mcupka/F0DisplayBoard/Components/Sophie/122861954_10218880609430510_2509081927859119019_n.jpg

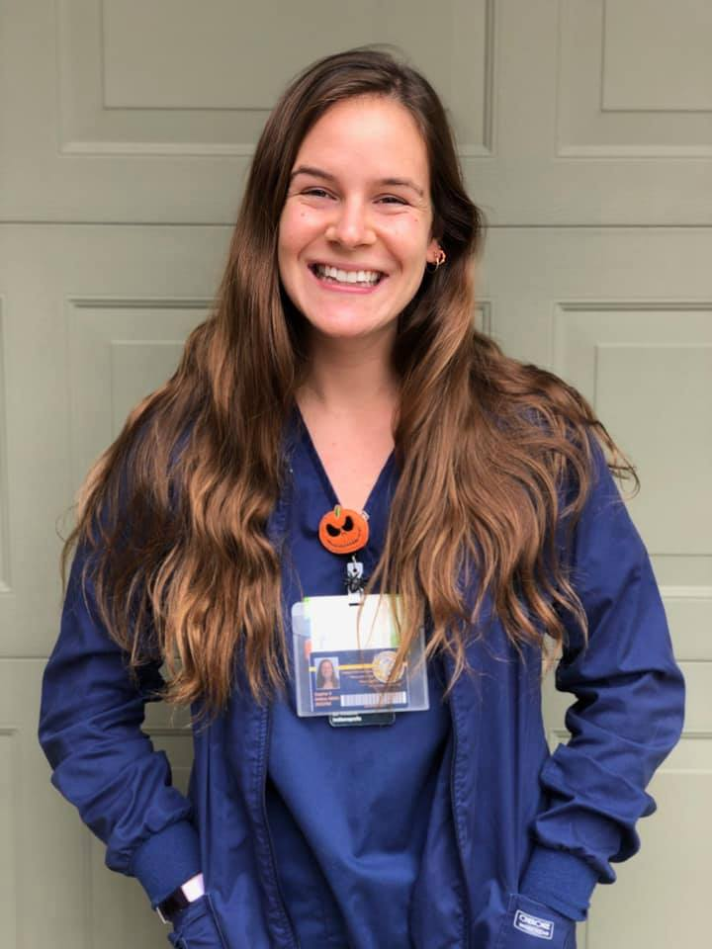
Components/Sophie/122861954_10218880609430510_2509081927859119019_n.jpg
