mcupka/F0DisplayBoard/3D_Models/pcb_casetop.stl

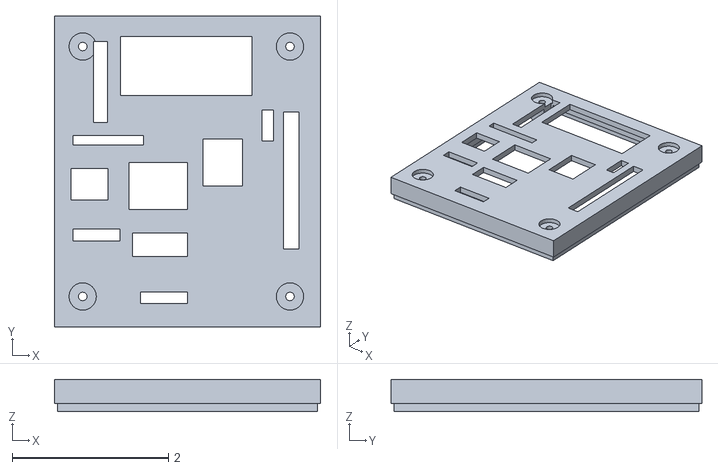
[picture p2: CAD file, 2020-12-15]
3D_Models/pcb_casetop.stl
3.40 x 3.98 x 0.41
