mcupka/F0DisplayBoard/3D_Models/pcb_casebottom_r2.stl

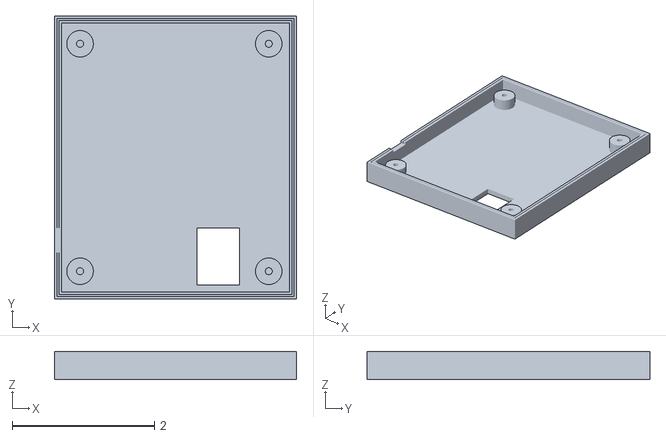
[picture p3: CAD file, 2020-12-15]
3D_Models/pcb_casebottom_r2.stl
3.40 x 3.98 x 0.4
