mcupka/F0DisplayBoard/3D_Models/pcb_stand.stl

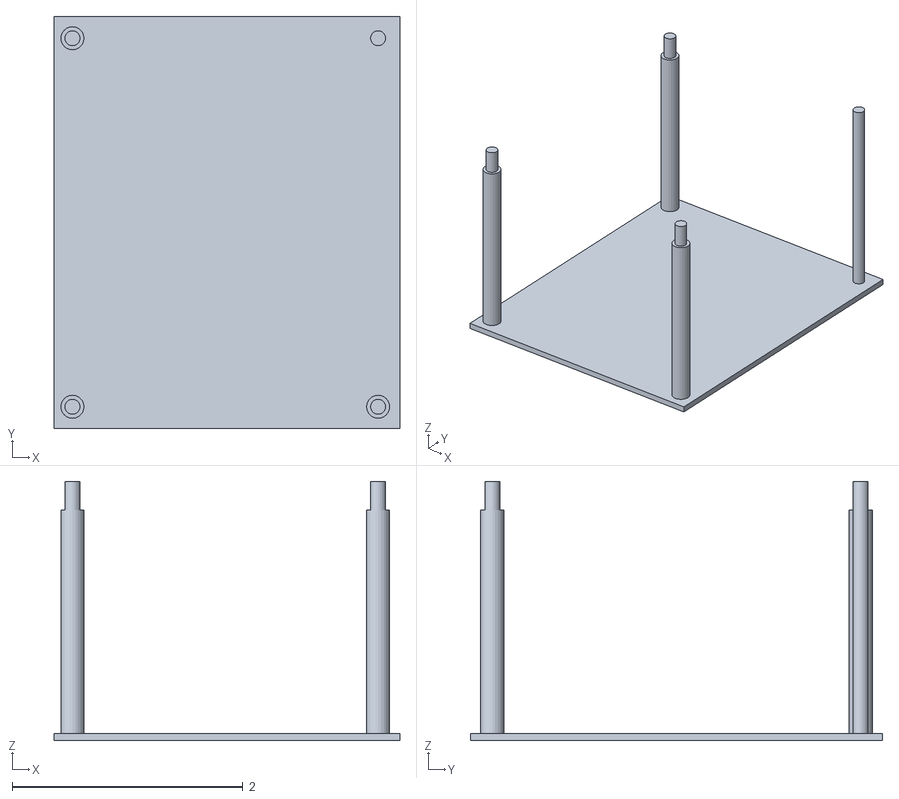
[picture p4: CAD file, 2020-12-15]
3D_Models/pcb_stand.stl
3.00 x 3.58 x 2.25
