mcupka/F0DisplayBoard/(list of files, cad)

Other CAD files:
3D_Models/pcb_casebottom_r2.dwg
3D_Models/pcb_casetop.dwg
