mcupka/F0DisplayBoard/F0DisplayBoard/F0DisplayBoard.kicad_pcb

## KiCad design F0DisplayBoard/F0DisplayBoard.kicad_pcb (2020-12-15)

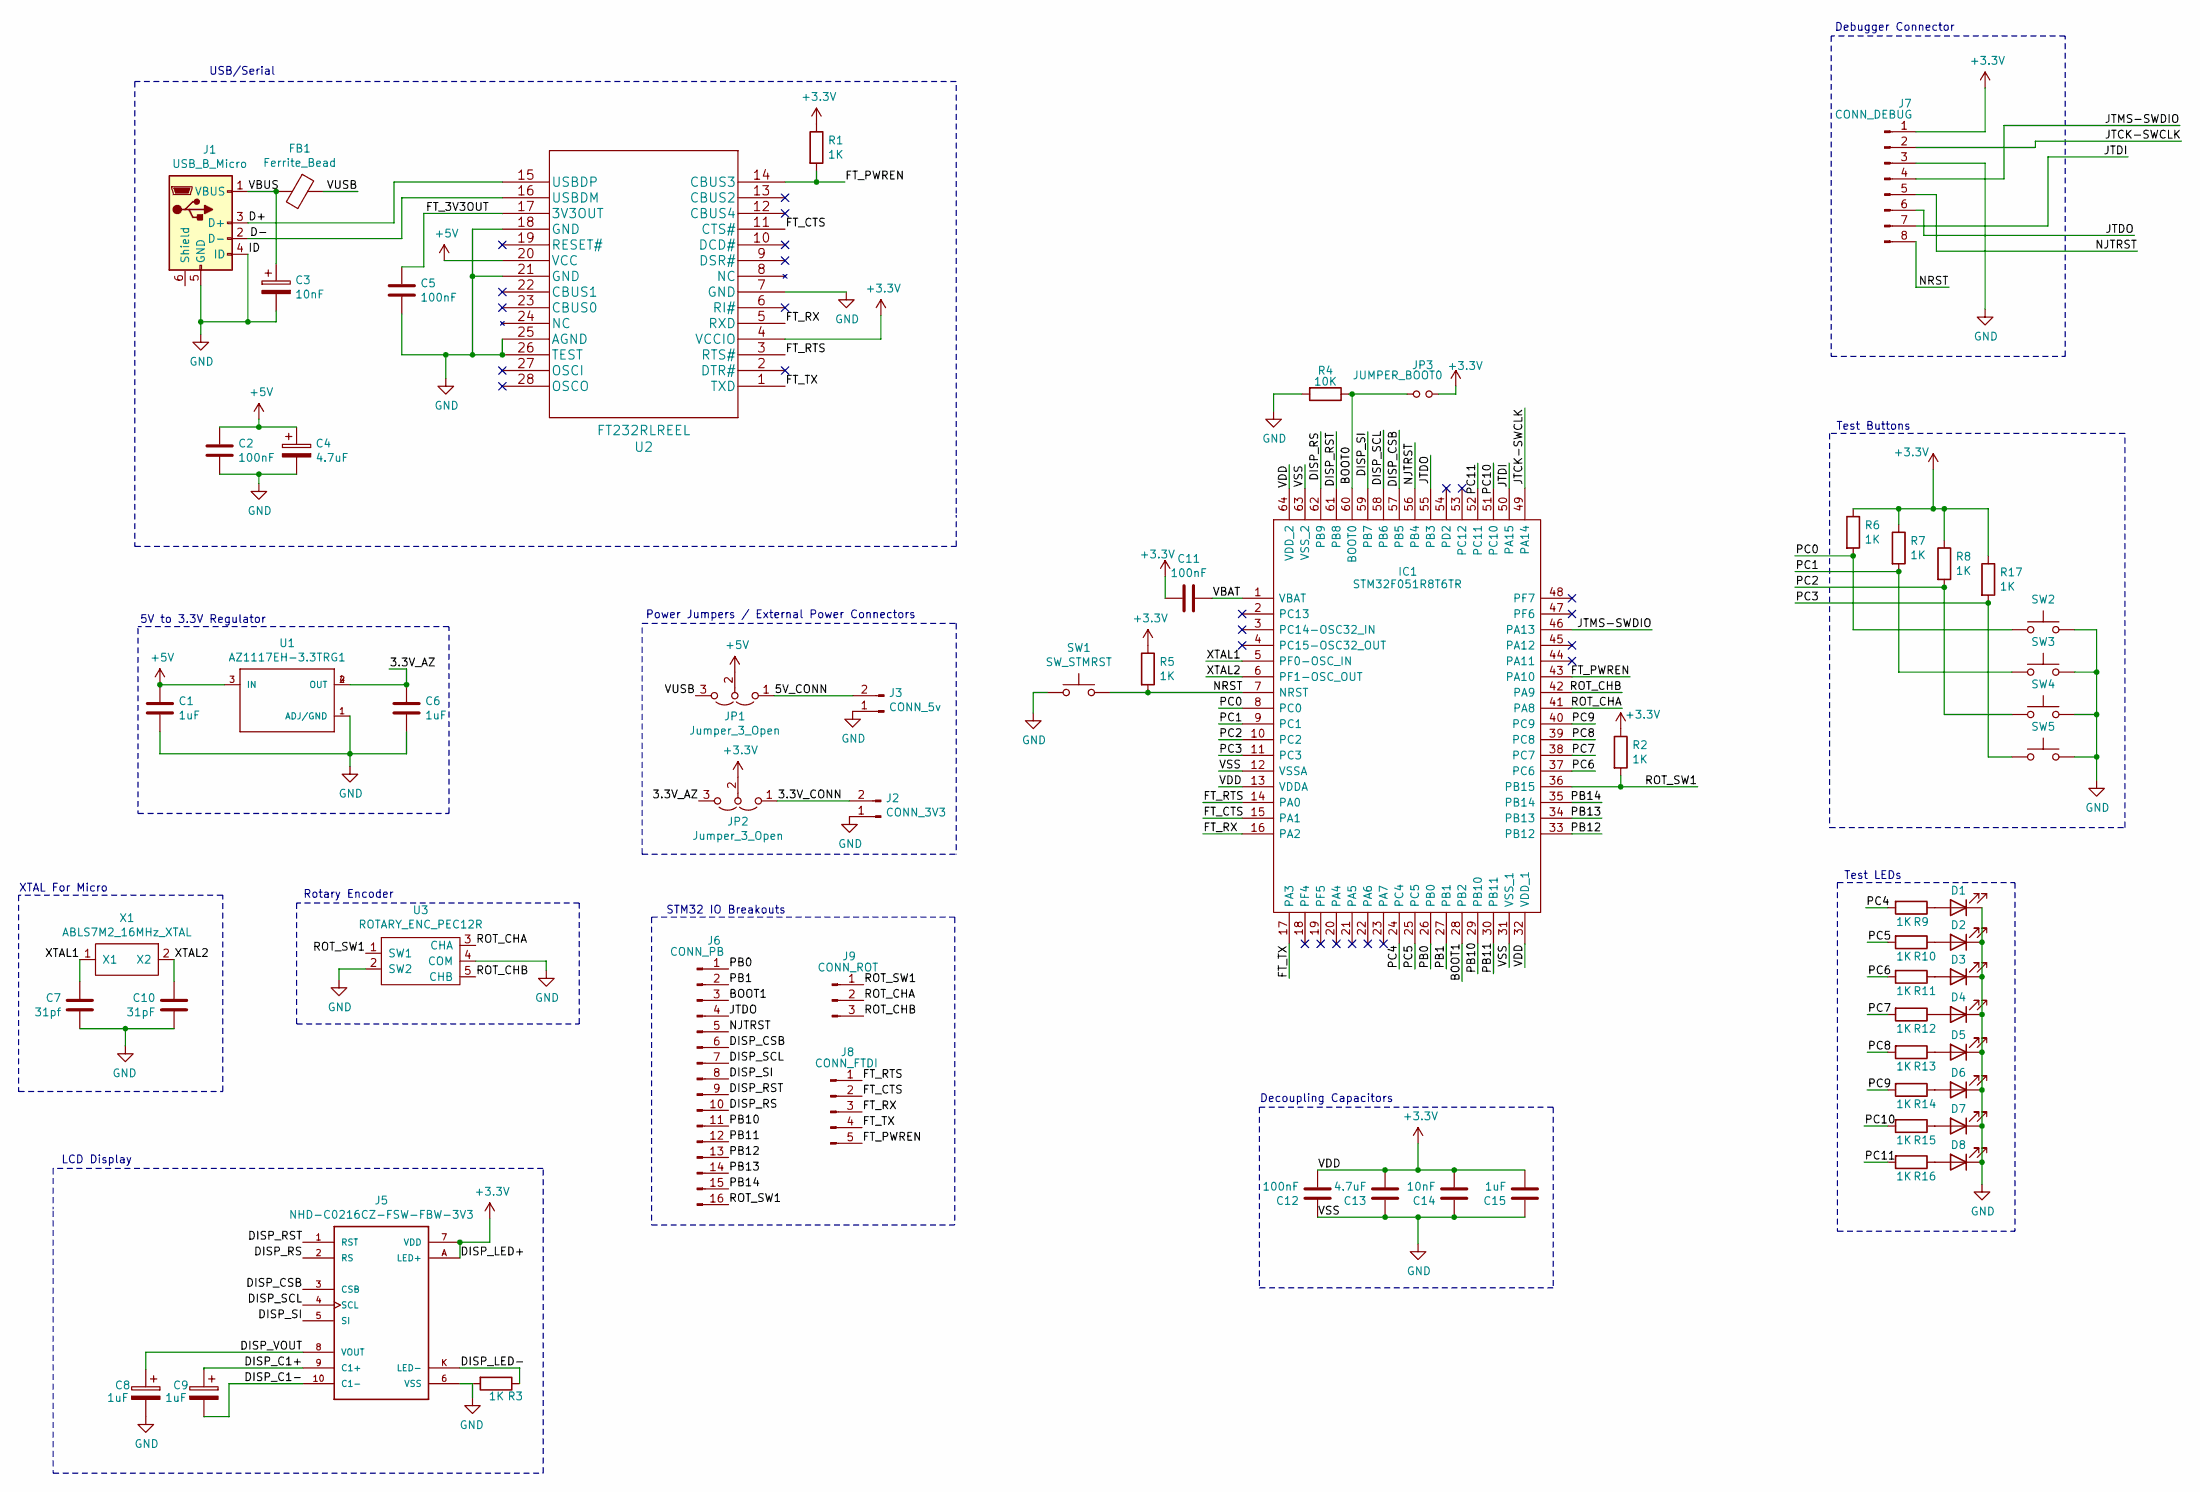
[picture p5: schematic F0DisplayBoard.sch]

Parts:
C1, C6, C8, C9, C15: 1uF; C_0805_2012Metric_Pad1.15x1.40mm_HandSolder
C2, C5, C11, C12: 100nF; C_0805_2012Metric_Pad1.15x1.40mm_HandSolder
C3, C14: 10nF; C_0805_2012Metric_Pad1.15x1.40mm_HandSolder
C4, C13: 4.7uF; C_0805_2012Metric_Pad1.15x1.40mm_HandSolder
C7: 31pf; C_0805_2012Metric_Pad1.15x1.40mm_HandSolder
C10: 31pF; C_0805_2012Metric_Pad1.15x1.40mm_HandSolder
D1, D2, D3, D4, D5, D6, D7, D8: LED; LED_0805_2012Metric_Pad1.15x1.40mm_HandSolder
FB1: Ferrite_Bead; R_0805_2012Metric_Pad1.15x1.40mm_HandSolder
IC1: STM32F051R8T6TR; QFP50P1200X1200X160-64N; Manufacturer_Part_Number STM32F051R8T6TR; Mouser Part Number 511-STM32F051R8T6TR
J1: USB_B_Micro; CUIDEVICES_UJ2-MIBH-4-SMT-TR
J2: CONN_3V3; PinHeader_1x02_P2.54mm_Vertical
J3: CONN_5v; PinHeader_1x02_P2.54mm_Vertical
J5: NHD-C0216CZ-FSW-FBW-3V3; LCD_NHD-C0216CZ-FSW-FBW-3V3
J6: CONN_PB; PinHeader_1x16_P2.54mm_Vertical
J7: CONN_DEBUG; PinHeader_1x08_P2.54mm_Vertical
J8: CONN_FTDI; PinHeader_1x05_P2.54mm_Vertical
J9: CONN_ROT; PinHeader_1x03_P2.54mm_Vertical
JP1, JP2: Jumper_3_Open; PinHeader_1x03_P2.54mm_Vertical
JP3: JUMPER_BOOT0; PinHeader_1x02_P2.54mm_Vertical
R1, R2, R3, R5, R6, R7, R8, R9, R10, R11, R12, R13, R14, R15, R16, R17: 1K; R_0805_2012Metric_Pad1.15x1.40mm_HandSolder
R4: 10K; R_0805_2012Metric_Pad1.15x1.40mm_HandSolder
SW1: SW_STMRST; PTS645SK43SMTR92LFS
SW2, SW3, SW4, SW5: SW_Push; PTS645SK43SMTR92LFS
U1: AZ1117EH-3.3TRG1; SOT230P700X180-4N
U2: FT232RLREEL
U3: ROTARY_ENC_PEC12R
X1: ABLS7M2_16MHz_XTAL; ABLS7M2

Connections:
+3V3: C11.2, C12.1, C13.1, C14.1, C15.1, IC1.13 (VDDA), IC1.32 (VDD_1), IC1.64 (VDD_2), J5.7 (VDD), J5.A (LED+), J7.1, JP2.2 (C), JP3.2, R1.1, R2.1, R5.1, R6.1, R7.1, R8.1, R17.1, U2.4 (VCCIO)
+5V: C1.1, C2.1, C4.1, JP1.2 (C), U1.3 (IN), U2.20 (VCC)
/3.3V_AZ: C6.1, JP2.3 (B), U1.2 (OUT), U1.4 (OUT)
/3.3V_CONN: J2.2, JP2.1 (A)
/5V_CONN: J3.2, JP1.1 (A)
/BOOT0: IC1.60 (BOOT0), JP3.1, R4.1
/BOOT1: IC1.28 (PB2), J6.3
/D+: J1.3 (D+), U2.15 (USBDP)
/D-: J1.2 (D-), U2.16 (USBDM)
/DISP_C1+: C9.1, J5.9 (C1+)
/DISP_C1-: C9.2, J5.10 (C1-)
/DISP_CSB: IC1.57 (PB5), J5.3 (CSB), J6.6
/DISP_LED-: J5.K (LED-), R3.1
/DISP_RS: IC1.62 (PB9), J5.2 (RS), J6.10
/DISP_RST: IC1.61 (PB8), J5.1 (RST), J6.9
/DISP_SCL: IC1.58 (PB6), J5.4 (SCL), J6.7
/DISP_SI: IC1.59 (PB7), J5.5 (SI), J6.8
/DISP_VOUT: C8.1, J5.8 (VOUT)
/FT_3V3OUT: C5.1, U2.17 (3V3OUT)
/FT_CTS: IC1.15 (PA1), J8.2, U2.11 (CTS#)
/FT_PWREN: IC1.43 (PA10), J8.5, R1.2, U2.14 (CBUS3)
/FT_RTS: IC1.14 (PA0), J8.1, U2.3 (RTS#)
/FT_RX: IC1.16 (PA2), J8.3, U2.5 (RXD)
/FT_TX: IC1.17 (PA3), J8.4, U2.1 (TXD)
/JTCK-SWCLK: IC1.49 (PA14), J7.2
/JTDI: IC1.50 (PA15), J7.7
/JTDO: IC1.55 (PB3), J6.4, J7.6
/JTMS-SWDIO: IC1.46 (PA13), J7.4
/NJTRST: IC1.56 (PB4), J6.5, J7.5
/NRST: IC1.7 (NRST), J7.8, R5.2, SW1.3, SW1.4
/PB0: IC1.26 (PB0), J6.1
/PB1: IC1.27 (PB1), J6.2
/PB10: IC1.29 (PB10), J6.11
/PB11: IC1.30 (PB11), J6.12
/PB12: IC1.33 (PB12), J6.13
/PB13: IC1.34 (PB13), J6.14
/PB14: IC1.35 (PB14), J6.15
/PC0: IC1.8 (PC0), R6.2, SW2.1, SW2.2
/PC1: IC1.9 (PC1), R7.2, SW3.1, SW3.2
/PC2: IC1.10 (PC2), R8.2, SW4.1, SW4.2
/PC3: IC1.11 (PC3), R17.2, SW5.1, SW5.2
/PC4: IC1.24 (PC4), R9.2
/PC5: IC1.25 (PC5), R10.2
/PC6: IC1.37 (PC6), R11.2
/PC7: IC1.38 (PC7), R12.2
/PC8: IC1.39 (PC8), R13.2
/PC9: IC1.40 (PC9), R14.2
/PC10: IC1.51 (PC10), R15.2
/PC11: IC1.52 (PC11), R16.2
/ROT_CHA: IC1.41 (PA8), J9.2, U3.3 (CHA)
/ROT_CHB: IC1.42 (PA9), J9.3, U3.5 (CHB)
/ROT_SW1: IC1.36 (PB15), J6.16, J9.1, R2.2, U3.1 (SW1)
/VBAT: C11.1, IC1.1 (VBAT)
/VBUS: C3.1, FB1.2, J1.1 (VBUS)
/VUSB: FB1.1, JP1.3 (B)
/XTAL1: C7.1, IC1.5 (PF0-OSC_IN), X1.1 (X1)
/XTAL2: C10.1, IC1.6 (PF1-OSC_OUT), X1.2 (X2)
GND: C1.2, C2.2, C3.2, C4.2, C5.2, C6.2, C7.2, C8.2, C10.2, C12.2, C13.2, C14.2, C15.2, D1.1 (K), D2.1 (K), D3.1 (K), D4.1 (K), D5.1 (K), D6.1 (K), D7.1 (K), D8.1 (K), IC1.12 (VSSA), IC1.31 (VSS_1), IC1.63 (VSS_2), J1.4 (ID), J1.5 (GND), J2.1, J3.1, J5.6 (VSS), J7.3, R3.2, R4.2, SW1.1, SW1.2, SW2.3, SW2.4, SW3.3, SW3.4, SW4.3, SW4.4, SW5.3, SW5.4, U1.1 (ADJ/GND), U2.7 (GND), U2.18 (GND), U2.21 (GND), U2.25 (AGND), U2.26 (TEST), U3.2 (SW2), U3.4 (COM)
unnamed: D1.2 (A), R9.1
unnamed: D2.2 (A), R10.1
unnamed: D3.2 (A), R11.1
unnamed: D4.2 (A), R12.1
unnamed: D5.2 (A), R13.1
unnamed: D6.2 (A), R14.1
unnamed: D7.2 (A), R15.1
unnamed: D8.2 (A), R16.1

Notes on the sheet:
5V to 3.3V Regulator
Rotary Encoder
XTAL For Micro
LCD Display
Power Jumpers / External Power Connectors
Debugger Connector
STM32 IO Breakouts
Test LEDs
Test Buttons
USB/Serial
Decoupling Capacitors

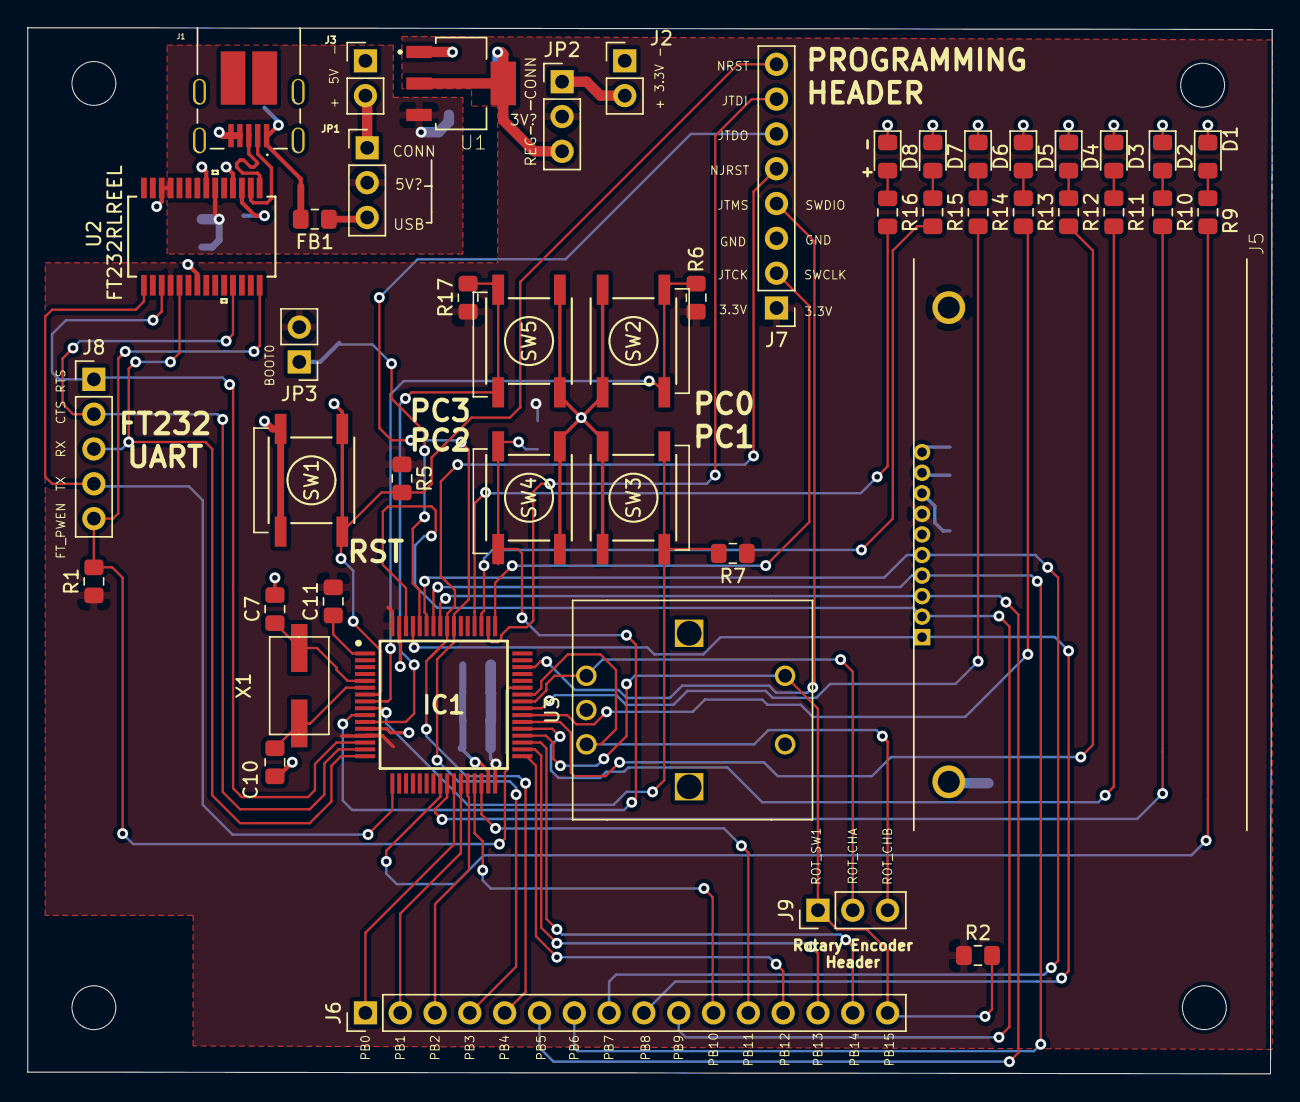
[picture p6: board F0DisplayBoard.kicad_pcb from above]

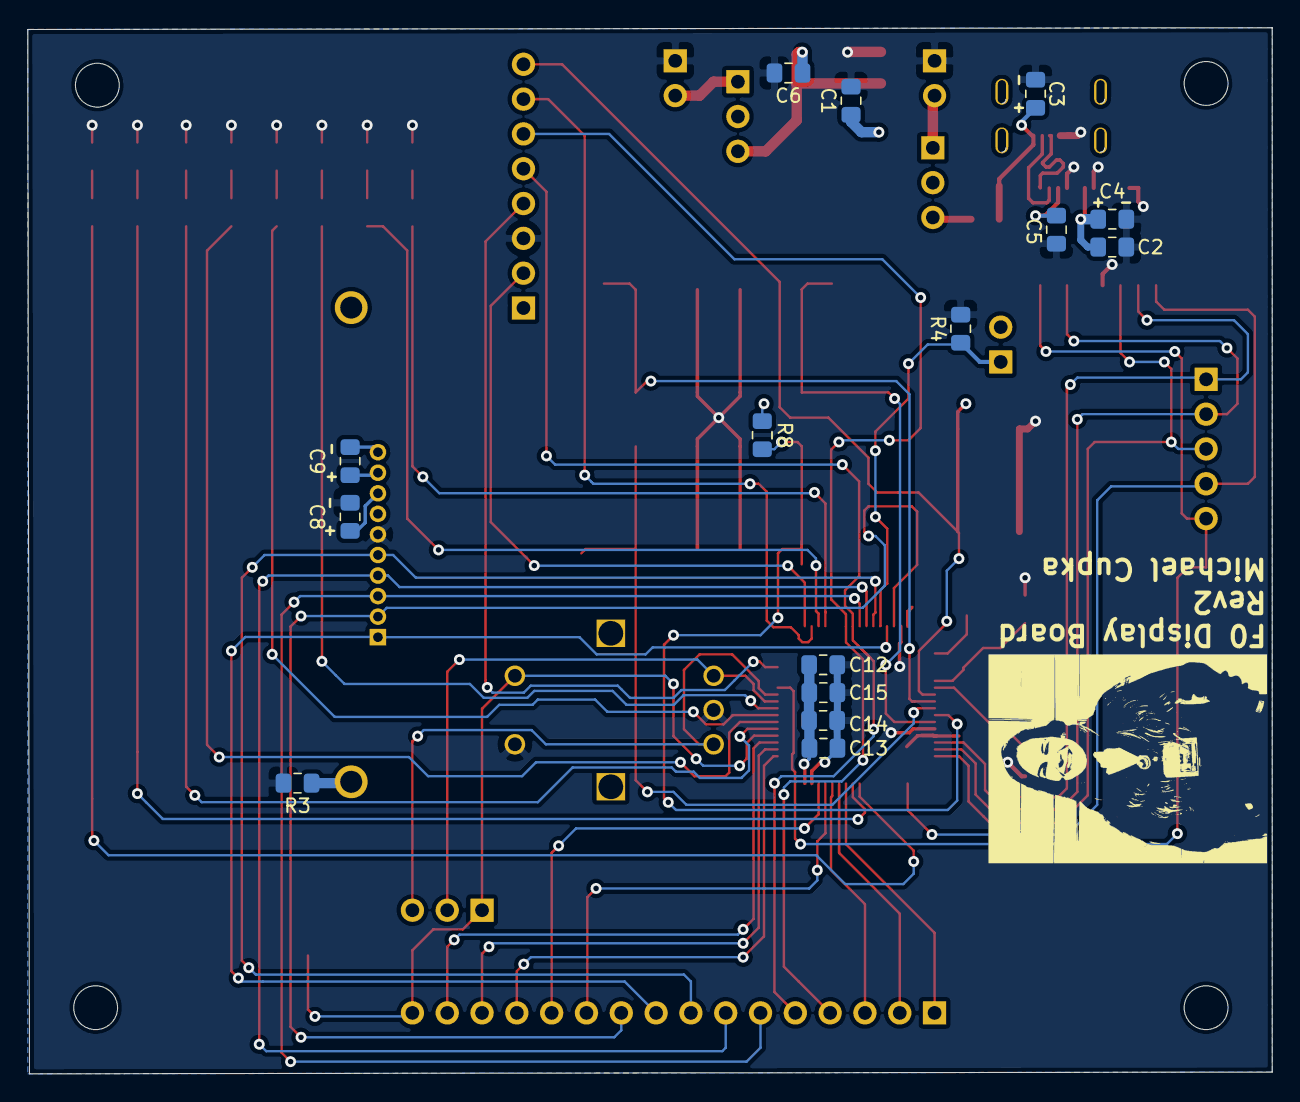
[picture p7: board F0DisplayBoard.kicad_pcb from below]

Board: 2 copper layers, 90.8 x 76.3 mm, 62 parts (15 on the bottom side), 66 nets.
