mcupka/F0DisplayBoard/sw/stmcube_uart_test/stmcube_uart_test/stmcube_uart_test.ioc

Mcu.UserName=STM32F051R8Tx
PA2.Signal=USART2_TX
PA3.Signal=USART2_RX
