mcupka/F0DisplayBoard/(commit log)

2020-10-18 Initial Commit: -Basically done with the main schematic -Need to add test points/connectors/LEDs -Need to begin layout
    [F0DisplayBoard.kicad_pcb, F0DisplayBoard.sch]
2020-10-30 sch: Removed some connectors to make room on board. pcb: rough routing, difficulty with traces cutting into planes. May restart routing of most signals
    [F0DisplayBoard.kicad_pcb, F0DisplayBoard.sch]
2020-11-01 pcb: re-routed mostlyl orthogonally. Still need to get 3.3V plane to reach some pins and check other "unrouted" signals
    [F0DisplayBoard.kicad_pcb]
2020-11-21 Rev2 completed -Added current-limiting resitstor for LCD backlight -Fixed microcontroller footprint -Board size reduced
    [F0DisplayBoard-B_Cu.gbr, F0DisplayBoard-B_Mask.gbr, F0DisplayBoard-B_Paste.gbr, F0DisplayBoard-B_SilkS.gbr, F0DisplayBoard-Edge_Cuts.gbr, F0DisplayBoard-F_Cu.gbr, F0DisplayBoard-F_Mask.gbr, F0DisplayBoard-F_Paste.gbr]
2020-11-21 sw: started sw -simple uart print test completed using STMCubeMX, HAL, and SW4STM32
    [lab6 Run.cfg]
2020-12-04 sw: modified UART test to show interactive test menu -Created test to blink LEDs and added to menu
2020-12-15 pcb: added some dimensions
    [F0DisplayBoard.kicad_pcb]
2020-12-15 3dcad: Added stand and case models. Designed using AutoCAD 2020 -Hole for programming header needs moved slightly. -Ridge needs widened / tab needs thinned. Currently, tab must be forced to fit into 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
    [pcb_casebottom_r2.dwg, pcb_casebottom_r2.stl, pcb_casetop.dwg, pcb_casetop.stl, pcb_stand.stl]
